zlosynth/handy/hardware/Module.kicad_pcb

## KiCad design hardware/Module.kicad_pcb (2024-09-29)

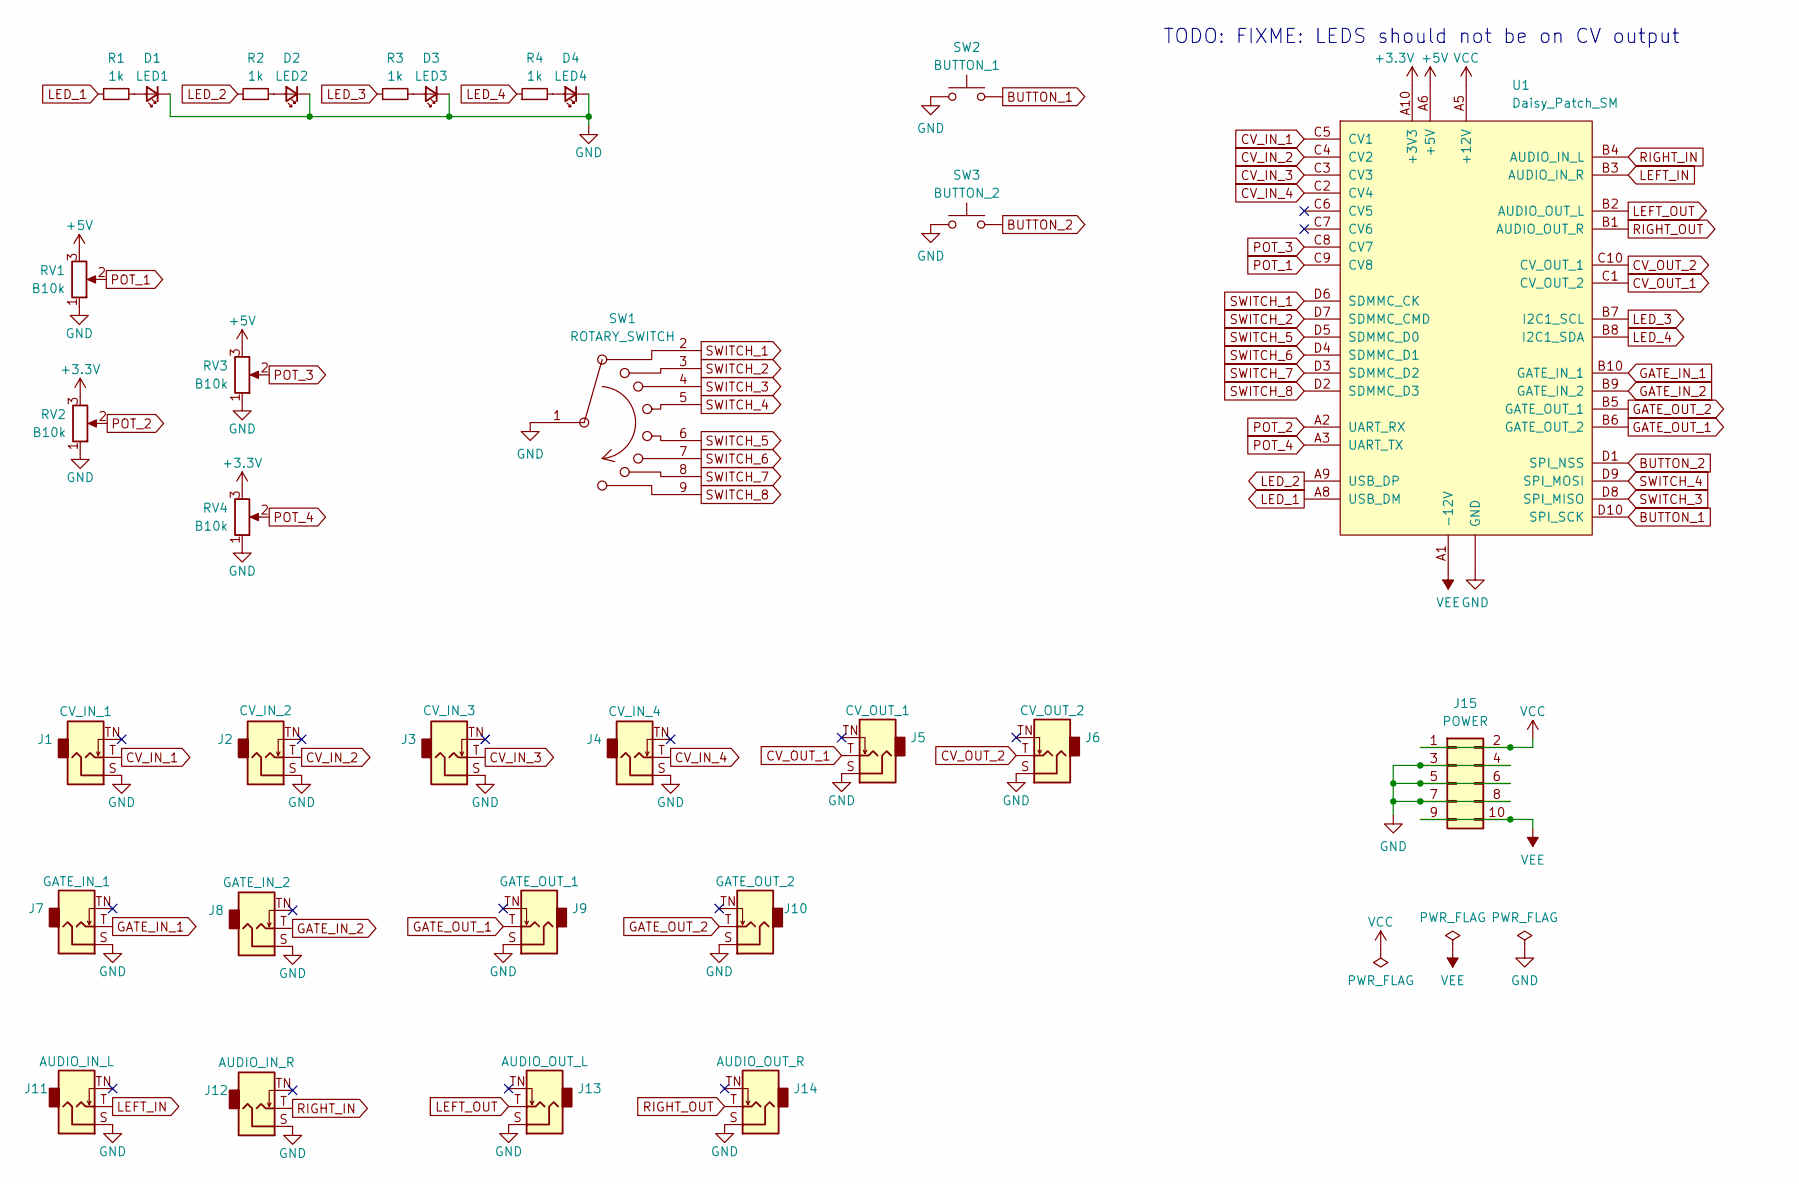
[picture p1: schematic Module.kicad_sch, Handy]

Parts:
D1: LED1; LED_D3.0mm
D2: LED2; LED_D3.0mm
D3: LED3; LED_D3.0mm
D4: LED4; LED_D3.0mm
J1: CV_IN_1; Jack_3.5mm_QingPu_WQP-PJ398SM_Vertical_CircularHoles
J2: CV_IN_2; Jack_3.5mm_QingPu_WQP-PJ398SM_Vertical_CircularHoles
J3: CV_IN_3; Jack_3.5mm_QingPu_WQP-PJ398SM_Vertical_CircularHoles
J4: CV_IN_4; Jack_3.5mm_QingPu_WQP-PJ398SM_Vertical_CircularHoles
J5: CV_OUT_1; Jack_3.5mm_QingPu_WQP-PJ398SM_Vertical_CircularHoles
J6: CV_OUT_2; Jack_3.5mm_QingPu_WQP-PJ398SM_Vertical_CircularHoles
J7: GATE_IN_1; Jack_3.5mm_QingPu_WQP-PJ398SM_Vertical_CircularHoles
J8: GATE_IN_2; Jack_3.5mm_QingPu_WQP-PJ398SM_Vertical_CircularHoles
J9: GATE_OUT_1; Jack_3.5mm_QingPu_WQP-PJ398SM_Vertical_CircularHoles
J10: GATE_OUT_2; Jack_3.5mm_QingPu_WQP-PJ398SM_Vertical_CircularHoles
J11: AUDIO_IN_L; Jack_3.5mm_QingPu_WQP-PJ398SM_Vertical_CircularHoles
J12: AUDIO_IN_R; Jack_3.5mm_QingPu_WQP-PJ398SM_Vertical_CircularHoles
J13: AUDIO_OUT_L; Jack_3.5mm_QingPu_WQP-PJ398SM_Vertical_CircularHoles
J14: AUDIO_OUT_R; Jack_3.5mm_QingPu_WQP-PJ398SM_Vertical_CircularHoles
J15: POWER; PinHeader_2x05_P2.54mm_Vertical
R1, R2, R3, R4: 1k; R_0805_2012Metric_Pad1.20x1.40mm_HandSolder
RV1, RV3: B10k; Potentiometer_Thonk_Trimmer
RV2, RV4: B10k; Potentiometer_Alpha_RD901F-40-00D_Single_Vertical
SW1: ROTARY_SWITCH; Rotary_Switch_8_Alpha
SW2: BUTTON_1; SW_PUSH_6mm
SW3: BUTTON_2; SW_PUSH_6mm
U1: Daisy_Patch_SM

Connections:
+3.3V: RV2.3, RV4.3, U1.A10 (+3V3)
+5V: RV1.3, RV3.3, U1.A6 (+5V)
BUTTON_1: SW2.2, U1.D10 (SPI_SCK)
BUTTON_2: SW3.2, U1.D1 (SPI_NSS)
CV_IN_1: J1.T, U1.C5 (CV1)
CV_IN_2: J2.T, U1.C4 (CV2)
CV_IN_3: J3.T, U1.C3 (CV3)
CV_IN_4: J4.T, U1.C2 (CV4)
CV_OUT_1: J5.T, U1.C1 (CV_OUT_2)
CV_OUT_2: J6.T, U1.C10 (CV_OUT_1)
GATE_IN_1: J7.T, U1.B10 (GATE_IN_1)
GATE_IN_2: J8.T, U1.B9 (GATE_IN_2)
GATE_OUT_1: J9.T, U1.B6 (GATE_OUT_2)
GATE_OUT_2: J10.T, U1.B5 (GATE_OUT_1)
GND: D1.1 (K), D2.1 (K), D3.1 (K), D4.1 (K), J1.S, J2.S, J3.S, J4.S, J5.S, J6.S, J7.S, J8.S, J9.S, J10.S, J11.S, J12.S, J13.S, J14.S, J15.3, J15.4, J15.5, J15.6, J15.7, J15.8, RV1.1, RV2.1, RV3.1, RV4.1, SW1.1, SW2.1, SW3.1, U1.A4 (GND), U1.A7 (GND)
LED_1: R1.1, U1.A8 (USB_DM)
LED_2: R2.1, U1.A9 (USB_DP)
LED_3: R3.1, U1.B7 (I2C1_SCL)
LED_4: R4.1, U1.B8 (I2C1_SDA)
LEFT_IN: J11.T, U1.B3 (AUDIO_IN_R)
LEFT_OUT: J13.T, U1.B2 (AUDIO_OUT_L)
unnamed: D1.2 (A), R1.2
unnamed: D2.2 (A), R2.2
unnamed: D3.2 (A), R3.2
unnamed: D4.2 (A), R4.2
POT_1: RV1.2, U1.C9 (CV8)
POT_2: RV2.2, U1.A2 (UART_RX)
POT_3: RV3.2, U1.C8 (CV7)
POT_4: RV4.2, U1.A3 (UART_TX)
RIGHT_IN: J12.T, U1.B4 (AUDIO_IN_L)
RIGHT_OUT: J14.T, U1.B1 (AUDIO_OUT_R)
SWITCH_1: SW1.2, U1.D6 (SDMMC_CK)
SWITCH_2: SW1.3, U1.D7 (SDMMC_CMD)
SWITCH_3: SW1.4, U1.D8 (SPI_MISO)
SWITCH_4: SW1.5, U1.D9 (SPI_MOSI)
SWITCH_5: SW1.6, U1.D5 (SDMMC_D0)
SWITCH_6: SW1.7, U1.D4 (SDMMC_D1)
SWITCH_7: SW1.8, U1.D3 (SDMMC_D2)
SWITCH_8: SW1.9, U1.D2 (SDMMC_D3)
VCC: J15.1, J15.2, U1.A5 (+12V)
VEE: J15.9, J15.10, U1.A1 (-12V)

Notes on the sheet:
TODO: FIXME: LEDS should not be on CV output

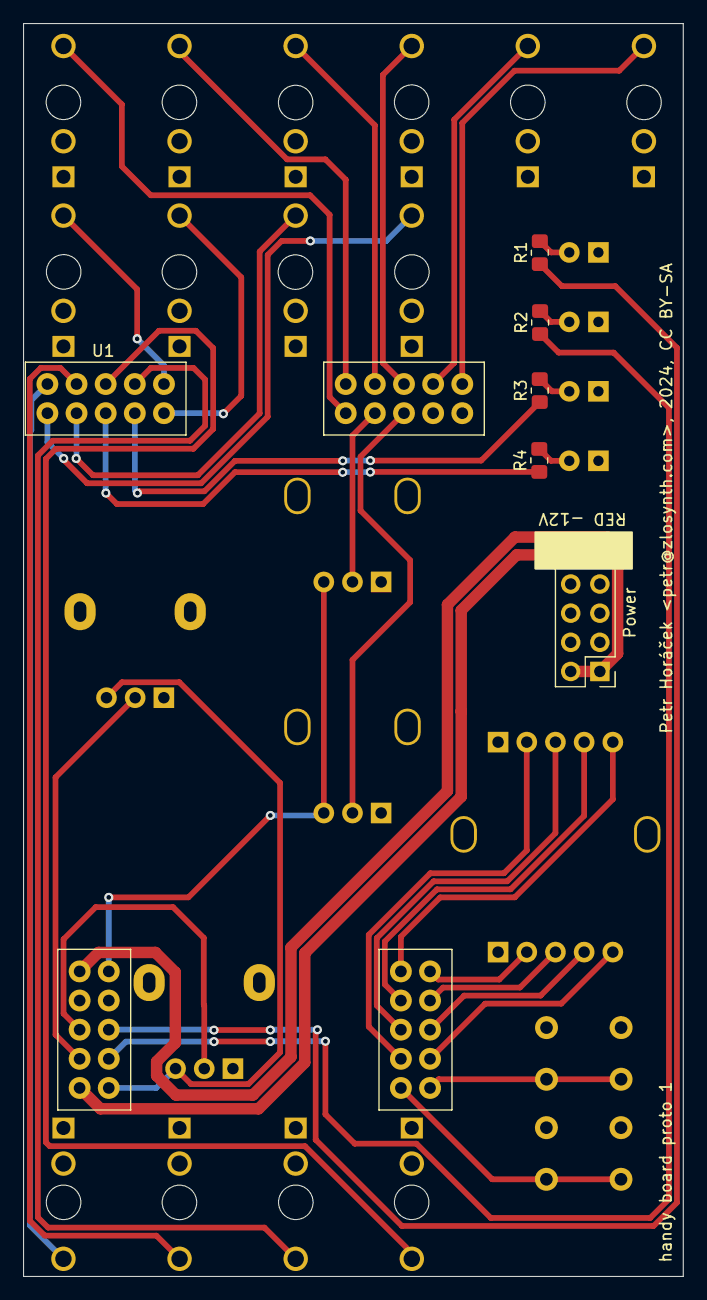
[picture p2: board Module.kicad_pcb from above]

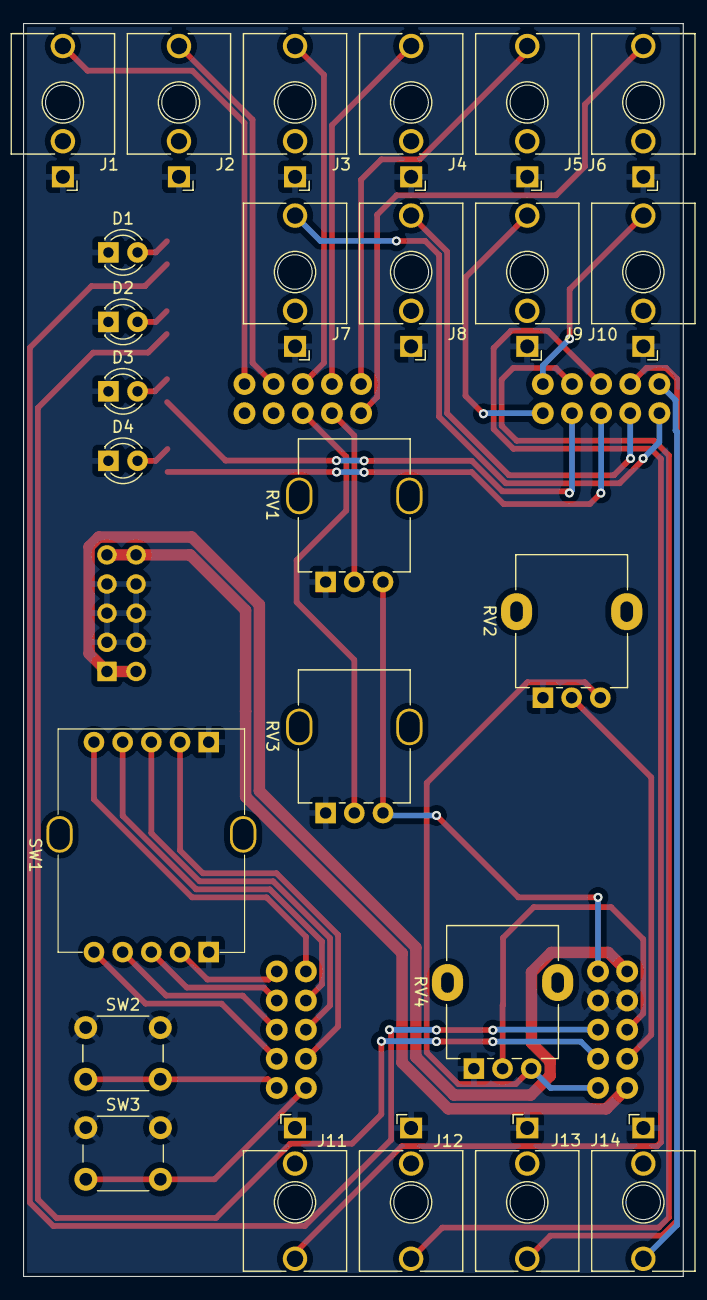
[picture p3: board Module.kicad_pcb from below]

Board: 2 copper layers, 57.5 x 109.2 mm, 31 parts (25 on the bottom side), 41 nets.
