zlosynth/handy/(commit log)

2024-09-18 Complete panel component placement on pcb
    [Module.kicad_pcb, Module.kicad_sch]
2024-09-18 Patch a rough schematic
    [Module.kicad_pcb, Module.kicad_sch]
2024-09-18 First wire up of the PCB
    [Module.kicad_pcb, Module.kicad_sch]
2024-09-18 Complete the ground plane and fix ERC
    [Module.kicad_pcb, Module.kicad_sch]
2024-09-18 Fix trimmer footprint
    [Module.kicad_pcb, Module.kicad_sch]
2024-09-19 Fix orientation of PCB label
    [Module.kicad_pcb]
2024-09-19 Fix power connector direction
    [Module.kicad_pcb]
2024-09-29 Fix LED daisy connection
    [Module.kicad_pcb, Module.kicad_sch]
