zlosynth/handy/(notices)

Notices in the files:
hardware/Module.kicad_sch:
CC BY-SA
hardware/Module.kicad_pcb:
Petr Horáček , 2024, CC BY-SA
